Corteil/sdhexpansion/sdhexpansion_v1/bom.csv

Comment | Designator | Footprint | LCSC
2.2uF | C2,C3 | Capacitor_SMD:C_0603_1608Metric | C23630
2.2kΩ | R2,R3,R4 | Resistor_SMD:R_0603_1608Metric | C4190
Micro_SD_Card | J3 | extras:MICRO-SD_XKTF-001C | C1121870
10kΩ | R5,R6,R7,R8,R9 | Resistor_SMD:R_0603_1608Metric | C25804
ZD24C64A-SSGMT | U1 | Package_SO:SOIC-8_3.9x4.9mm_P1.27mm | C2896793
TPS2041B | U2 | Package_TO_SOT_SMD:SOT-23-5 | C24593
