Corteil/sdhexpansion/sdhexpansion.kicad_pcb

## KiCad design sdhexpansion.kicad_pcb (2026-05-31)

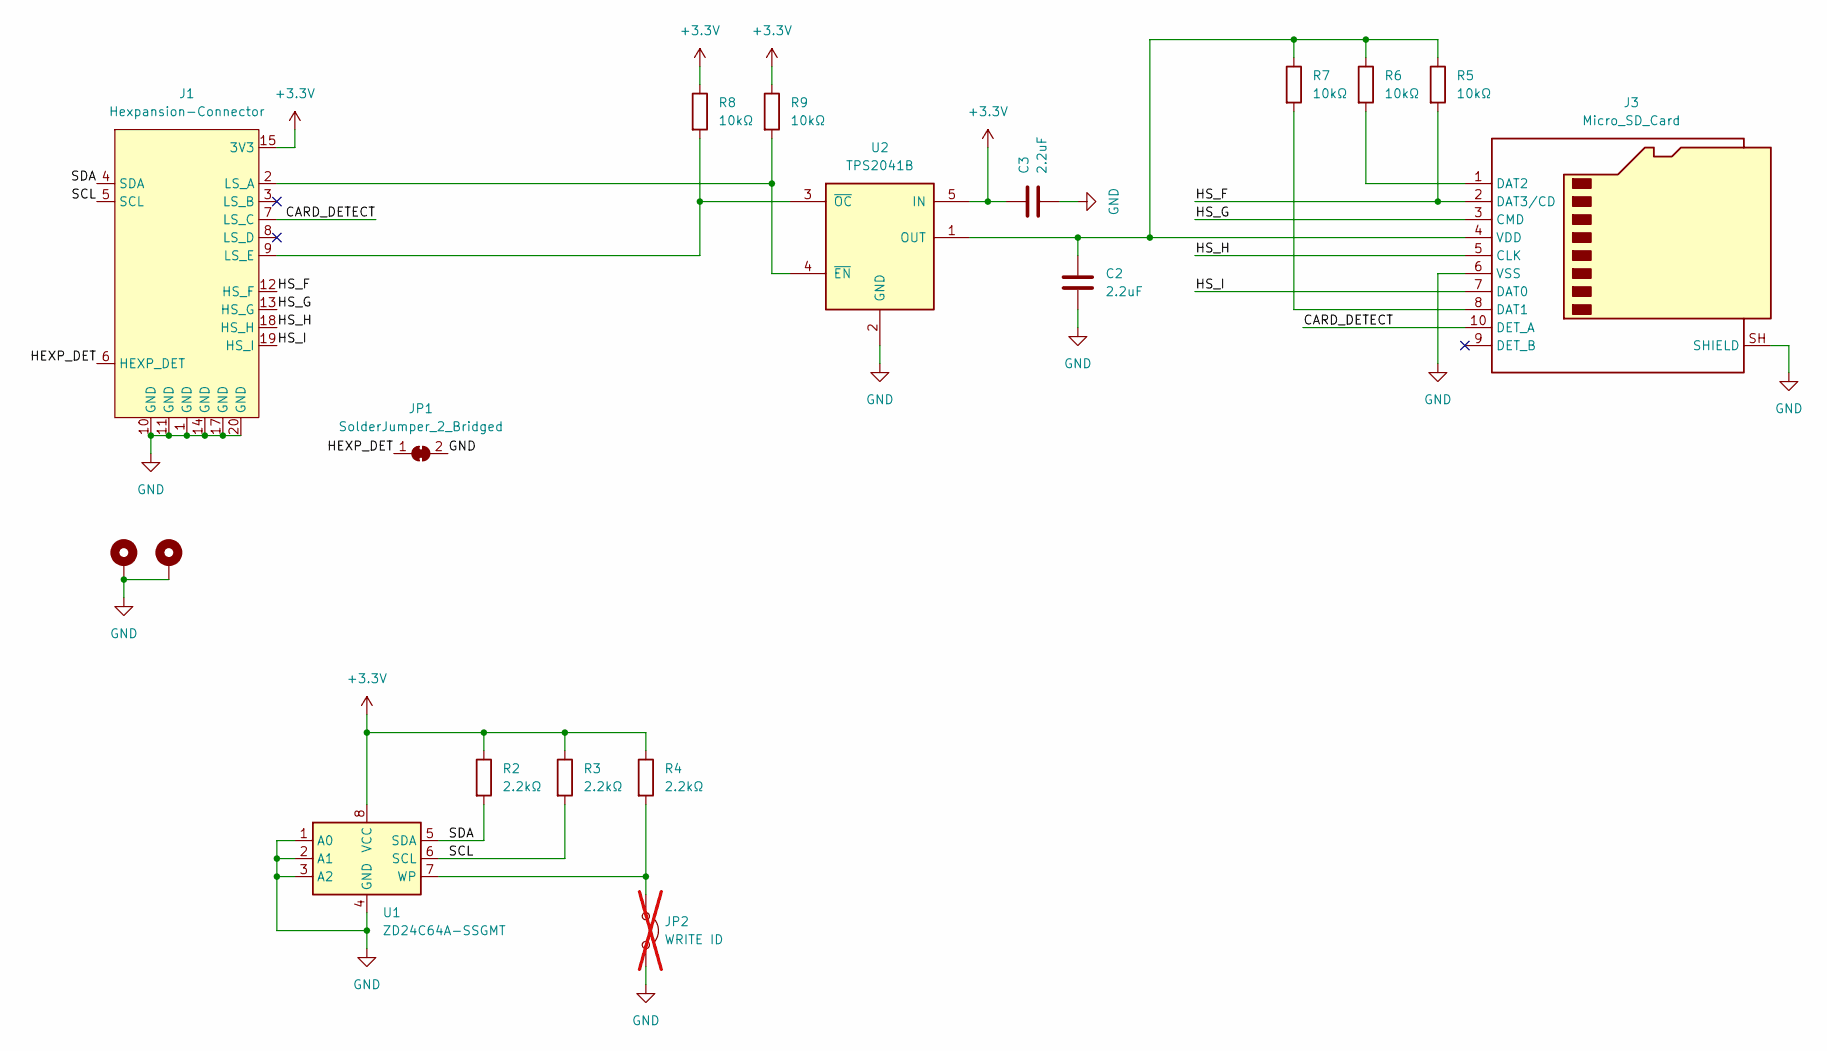
[picture p2: schematic sdhexpansion.kicad_sch]

Parts:
C2, C3: 2.2uF; C_0603_1608Metric; LCSC C23630
H1, H2: MountingHole_Pad; MountingHole_2.2mm_M2_Pad_Via
J1: Hexpansion-Connector; hexpansion-edge-connector
J3: Micro_SD_Card; MICRO-SD_XKTF-001C; LCSC C1121870
JP1: SolderJumper_2_Bridged; SolderJumper-2_P1.3mm_Bridged_RoundedPad1.0x1.5mm
JP2: WRITE ID; PinHeader_1x02_P2.54mm_Vertical; not fitted
R2, R3, R4: 2.2kΩ; R_0603_1608Metric; LCSC C4190
R5, R6, R7, R8, R9: 10kΩ; R_0603_1608Metric; LCSC C25804
U1: ZD24C64A-SSGMT; SOIC-8_3.9x4.9mm_P1.27mm; LCSC C2896793
U2: TPS2041B; SOT-23-5; LCSC C24593

Connections:
+3.3V: C3.2, J1.15 (3V3), J1.16 (3V3), R2.1, R3.1, R4.1, R8.1, R9.1, U1.8 (VCC), U2.5 (IN)
/CARD_DETECT: J1.7 (LS_C), J3.10 (DET_A)
/HEXP_DET: J1.6 (HEXP_DET), JP1.1 (A)
/HS_F: J1.12 (HS_F), J3.2 (DAT3/CD), R5.2
/HS_G: J1.13 (HS_G), J3.3 (CMD)
/HS_H: J1.18 (HS_H), J3.5 (CLK)
/HS_I: J1.19 (HS_I), J3.7 (DAT0)
/SCL: J1.5 (SCL), R3.2, U1.6 (SCL)
/SDA: J1.4 (SDA), R2.2, U1.5 (SDA)
GND: C2.1, C3.1, H1.1 (1_1), H2.1 (1_1), J1.1 (GND), J1.10 (GND), J1.11 (GND), J1.14 (GND), J1.17 (GND), J1.20 (GND), J3.6 (VSS), J3.SH (SHIELD), JP1.2 (B), JP2.2 (B), U1.1 (A0), U1.2 (A1), U1.3 (A2), U1.4 (GND), U2.2 (GND)
unnamed: J1.2 (LS_A), R9.2, U2.4 (~EN)
unnamed: J1.9 (LS_E), R8.2, U2.3 (~OC)
unnamed: J3.8 (DAT1), R7.2
unnamed: J3.1 (DAT2), R6.2
unnamed: C2.2, J3.4 (VDD), R5.1, R6.1, R7.1, U2.1 (OUT)
unnamed: JP2.1 (A), R4.2, U1.7 (WP)

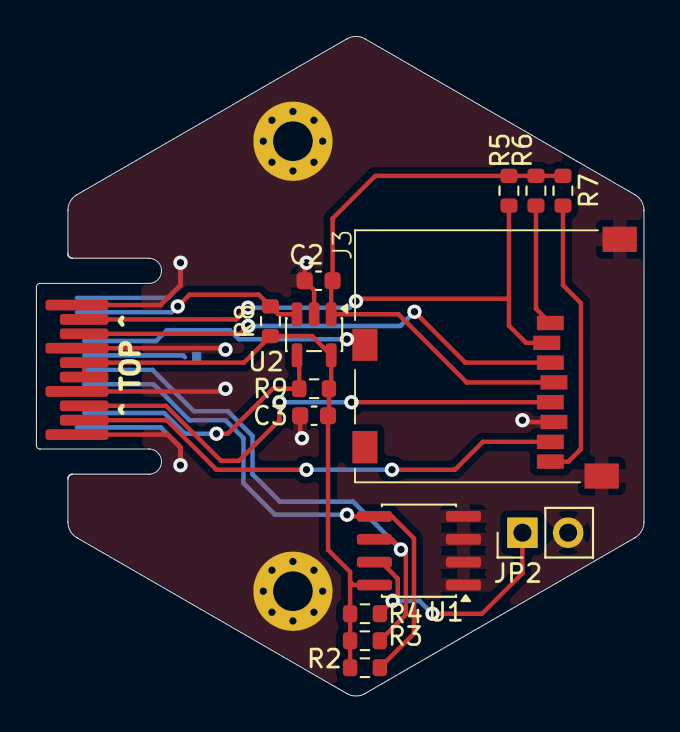
[picture p3: board sdhexpansion.kicad_pcb from above]

Board: 2 copper layers, 33.7 x 36.6 mm, 18 parts (1 on the bottom side), 16 nets.
