Corteil/sdhexpansion/sdhexpansion-panel.kicad_pcb

## KiCad design sdhexpansion-panel.kicad_pcb (2026-05-31)

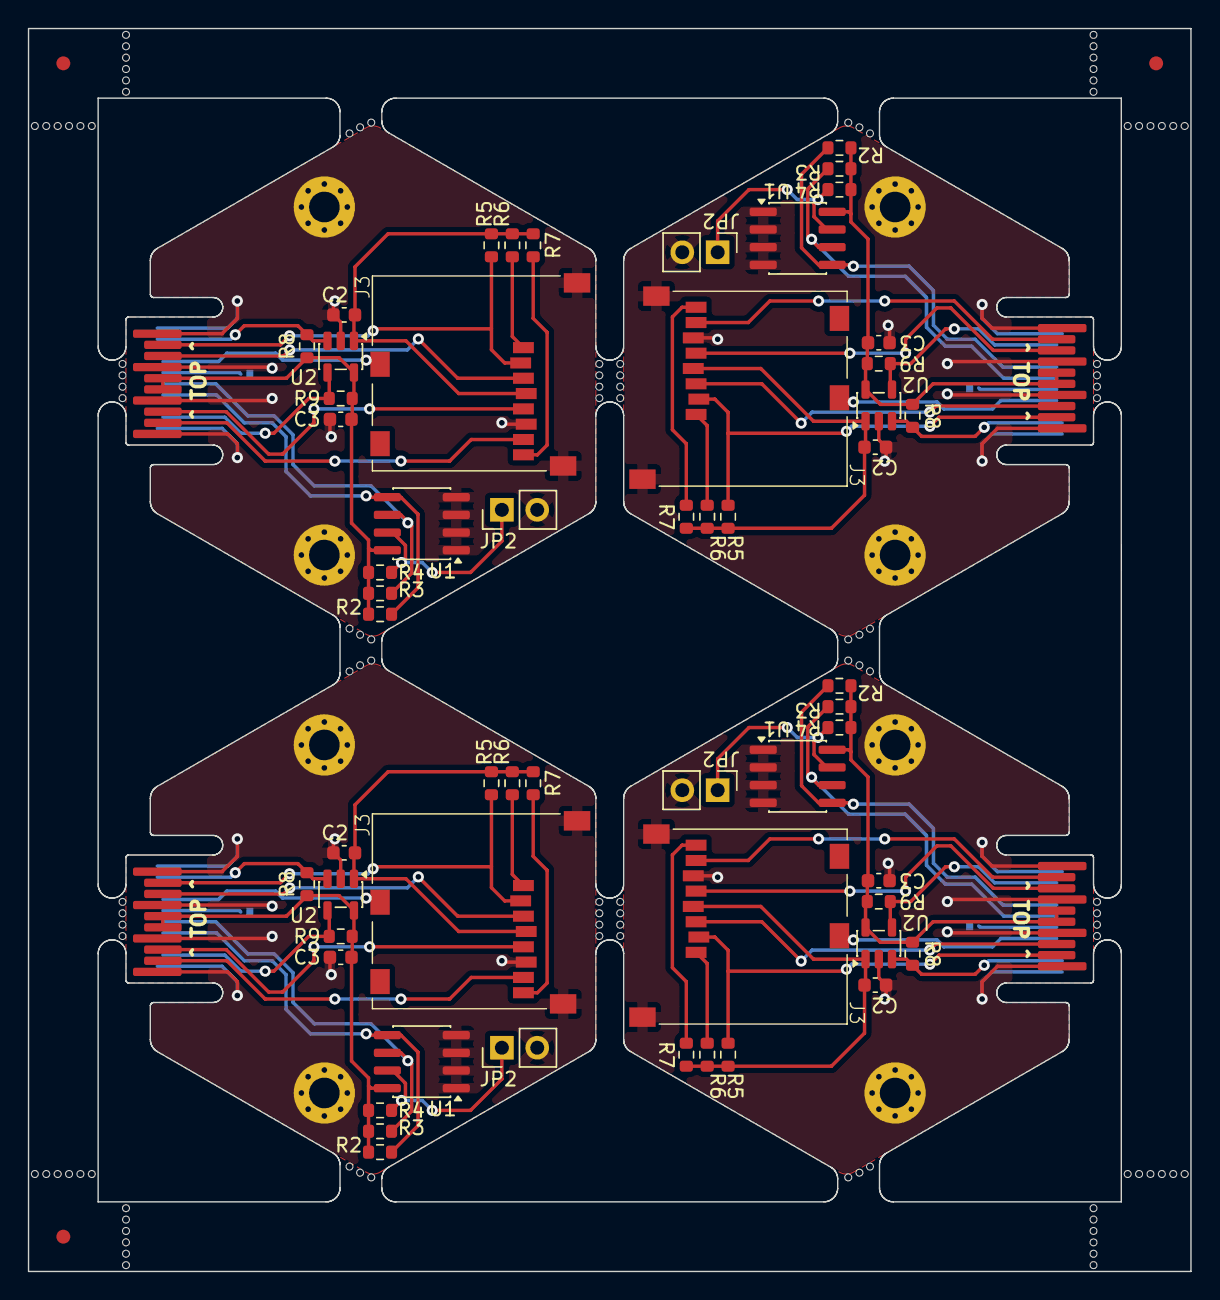
[picture p4: board sdhexpansion-panel.kicad_pcb from above]

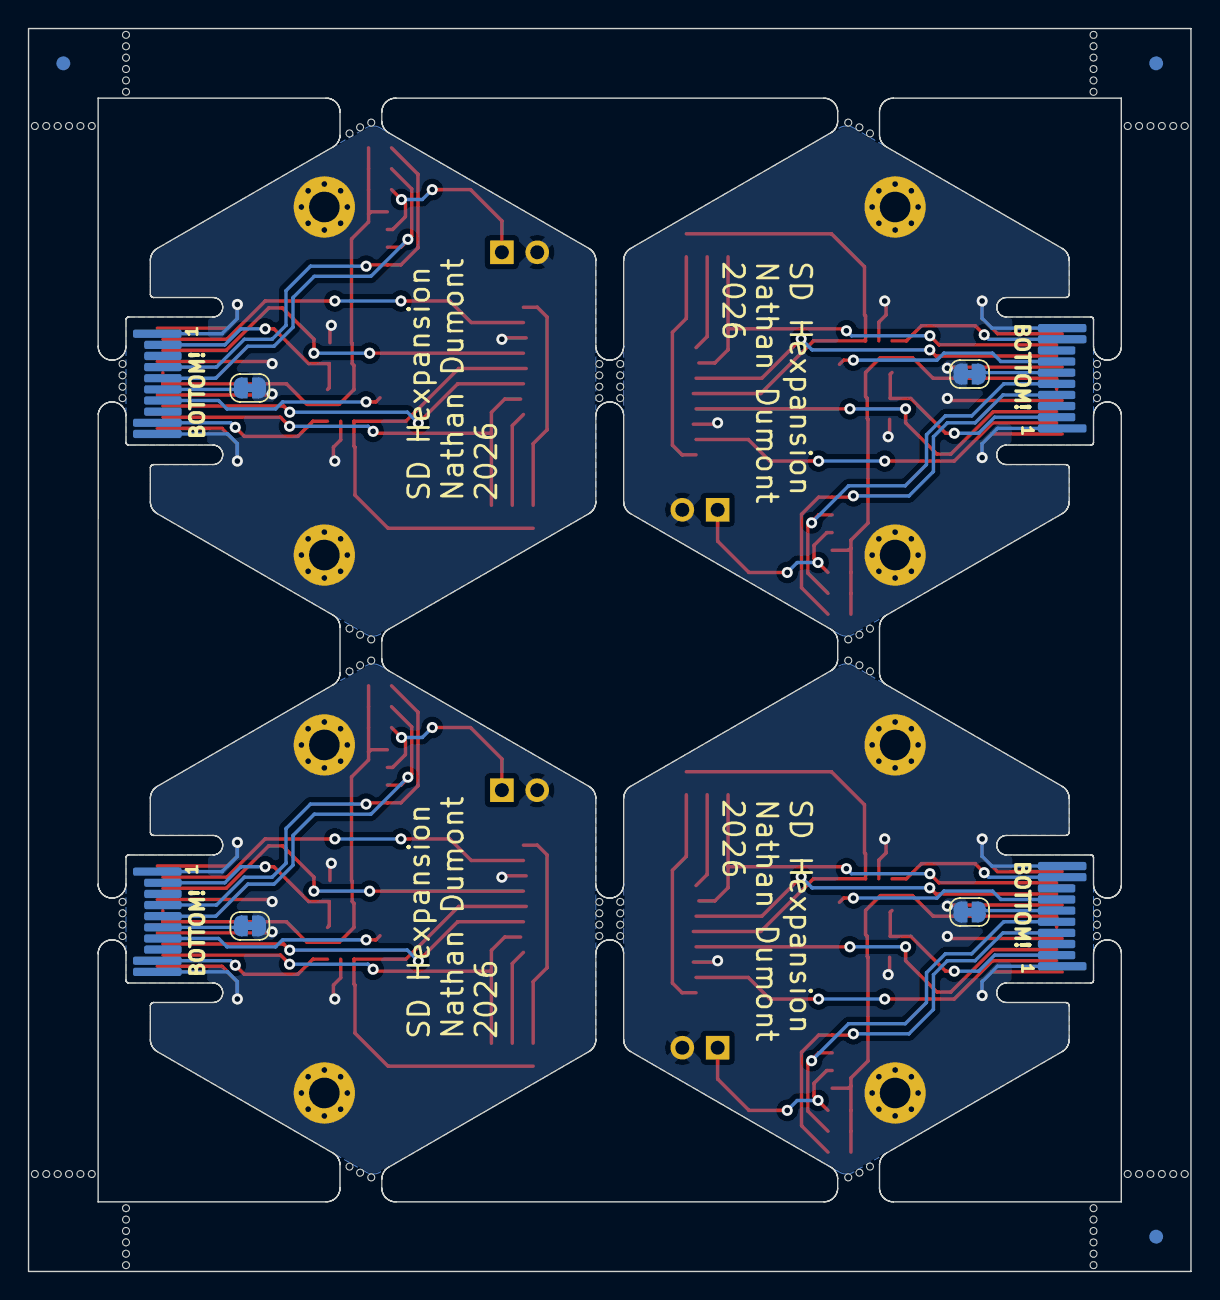
[picture p5: board sdhexpansion-panel.kicad_pcb from below]

Board: 2 copper layers, 83.5 x 89.3 mm, 182 parts (7 on the bottom side), 64 nets.

Parts:
C2, C2#2, C2#3, C2#4, C3, C3#2, C3#3, C3#4: 2.2uF; C_0603_1608Metric
H1, H1#2, H1#3, H1#4, H2, H2#2, H2#3, H2#4: MountingHole_Pad; MountingHole_2.2mm_M2_Pad_Via
J1, J1#2, J1#3, J1#4: Hexpansion-Connector; hexpansion-edge-connector
J3, J3#2, J3#3, J3#4: Micro_SD_Card; MICRO-SD_XKTF-001C
JP1, JP1#2, JP1#3, JP1#4: SolderJumper_2_Bridged; SolderJumper-2_P1.3mm_Bridged_RoundedPad1.0x1.5mm
JP2, JP2#2, JP2#3, JP2#4: WRITE ID; PinHeader_1x02_P2.54mm_Vertical
KiKit_FID_B_1, KiKit_FID_B_2, KiKit_FID_B_3: Fiducial
KiKit_FID_T_1, KiKit_FID_T_2, KiKit_FID_T_3: Fiducial
KiKit_MB_1_5, KiKit_MB_1_6, KiKit_MB_1_7, KiKit_MB_1_8, KiKit_MB_2_5, KiKit_MB_2_6, KiKit_MB_2_7, KiKit_MB_2_8, KiKit_MB_3_5, KiKit_MB_3_6, KiKit_MB_3_7, KiKit_MB_4_5, KiKit_MB_4_6, KiKit_MB_4_7, KiKit_MB_5_5, KiKit_MB_5_6, KiKit_MB_5_7, KiKit_MB_5_8, KiKit_MB_6_5, KiKit_MB_6_6, KiKit_MB_6_7, KiKit_MB_6_8, KiKit_MB_7_5, KiKit_MB_7_6, KiKit_MB_7_7, KiKit_MB_8_5, KiKit_MB_8_6, KiKit_MB_8_7, KiKit_MB_9_5, KiKit_MB_9_6, KiKit_MB_9_7, KiKit_MB_9_8, KiKit_MB_10_5, KiKit_MB_10_6, KiKit_MB_10_7, KiKit_MB_10_8, KiKit_MB_11_5, KiKit_MB_11_6, KiKit_MB_11_7, KiKit_MB_12_5, KiKit_MB_12_6, KiKit_MB_12_7, KiKit_MB_13_5, KiKit_MB_13_6, KiKit_MB_13_7, KiKit_MB_13_8, KiKit_MB_14_5, KiKit_MB_14_6, KiKit_MB_14_7, KiKit_MB_14_8, KiKit_MB_15_5, KiKit_MB_15_6, KiKit_MB_15_7, KiKit_MB_16_5, KiKit_MB_16_6, KiKit_MB_16_7, KiKit_MB_17_4, KiKit_MB_17_5, KiKit_MB_17_6, KiKit_MB_17_7, KiKit_MB_17_8, KiKit_MB_17_9, KiKit_MB_18_4, KiKit_MB_18_5, KiKit_MB_18_6, KiKit_MB_18_7, KiKit_MB_18_8, KiKit_MB_18_9, KiKit_MB_19_4, KiKit_MB_19_5, KiKit_MB_19_6, KiKit_MB_19_7, KiKit_MB_19_8, KiKit_MB_19_9, KiKit_MB_20_4, KiKit_MB_20_5, KiKit_MB_20_6, KiKit_MB_20_7, KiKit_MB_20_8, KiKit_MB_20_9, KiKit_MB_21_4, KiKit_MB_21_5, KiKit_MB_21_6, KiKit_MB_21_7, KiKit_MB_21_8, KiKit_MB_21_9, KiKit_MB_22_4, KiKit_MB_22_5, KiKit_MB_22_6, KiKit_MB_22_7, KiKit_MB_22_8, KiKit_MB_22_9, KiKit_MB_23_4, KiKit_MB_23_5, KiKit_MB_23_6, KiKit_MB_23_7, KiKit_MB_23_8, KiKit_MB_23_9, KiKit_MB_24_4, KiKit_MB_24_5, KiKit_MB_24_6, KiKit_MB_24_7, KiKit_MB_24_8, KiKit_MB_24_9: NPTH
R2, R2#2, R2#3, R2#4, R3, R3#2, R3#3, R3#4, R4, R4#2, R4#3, R4#4: 2.2kΩ; R_0603_1608Metric
R5, R5#2, R5#3, R5#4, R6, R6#2, R6#3, R6#4, R7, R7#2, R7#3, R7#4, R8, R8#2, R8#3, R8#4, R9, R9#2, R9#3, R9#4: 10kΩ; R_0603_1608Metric
U1, U1#2, U1#3, U1#4: ZD24C64A-SSGMT; SOIC-8_3.9x4.9mm_P1.27mm
U2, U2#2, U2#3, U2#4: TPS2041B; SOT-23-5

Connections:
Board_0-+3.3V: C3.2, J1.15 (3V3), J1.16 (3V3), R2.1, R3#3.1, R4#2.1, R8#4.1, R9#3.1, U1#4.8 (VCC), U2#3.5 (IN)
Board_0-/CARD_DETECT: J1.7 (LS_C), J3#4.10 (DET_A)
Board_0-/HEXP_DET: J1.6 (HEXP_DET), JP1#4.1 (A)
Board_0-/HS_F: J1.12 (HS_F), J3#4.2 (DAT3/CD), R5.2
Board_0-/HS_G: J1.13 (HS_G), J3#4.3 (CMD)
Board_0-/HS_H: J1.18 (HS_H), J3#4.5 (CLK)
Board_0-/HS_I: J1.19 (HS_I), J3#4.7 (DAT0)
Board_0-/SCL: J1.5 (SCL), R3#3.2, U1#4.6 (SCL)
Board_0-/SDA: J1.4 (SDA), R2.2, U1#4.5 (SDA)
Board_0-GND: C2#2.1, C3.1, H1#2.1 (1_1), H2.1 (1_1), J1.1 (GND), J1.10 (GND), J1.11 (GND), J1.14 (GND), J1.17 (GND), J1.20 (GND), J3#4.6 (VSS), J3#4.SH (SHIELD), JP1#4.2 (B), JP2.2 (B), U1#4.1 (A0), U1#4.2 (A1), U1#4.3 (A2), U1#4.4 (GND), U2#3.2 (GND)
Board_0-Net-(J1-LS_A): J1.2 (LS_A), R9#3.2, U2#3.4 (~EN)
Board_0-Net-(J1-LS_E): J1.9 (LS_E), R8#4.2, U2#3.3 (~OC)
Board_0-Net-(J3-DAT1): J3#4.8 (DAT1), R7#4.2
Board_0-Net-(J3-DAT2): J3#4.1 (DAT2), R6.2
Board_0-Net-(J3-VDD): C2#2.2, J3#4.4 (VDD), R5.1, R6.1, R7#4.1, U2#3.1 (OUT)
Board_0-Net-(JP2-A): JP2.1 (A), R4#2.2, U1#4.7 (WP)
Board_1-+3.3V: C3#3.2, J1#2.15 (3V3), J1#2.16 (3V3), R2#4.1, R3.1, R4#3.1, R8#2.1, R9.1, U1.8 (VCC), U2#4.5 (IN)
Board_1-/CARD_DETECT: J1#2.7 (LS_C), J3#2.10 (DET_A)
Board_1-/HEXP_DET: J1#2.6 (HEXP_DET), JP1.1 (A)
Board_1-/HS_F: J1#2.12 (HS_F), J3#2.2 (DAT3/CD), R5#3.2
Board_1-/HS_G: J1#2.13 (HS_G), J3#2.3 (CMD)
Board_1-/HS_H: J1#2.18 (HS_H), J3#2.5 (CLK)
Board_1-/HS_I: J1#2.19 (HS_I), J3#2.7 (DAT0)
Board_1-/SCL: J1#2.5 (SCL), R3.2, U1.6 (SCL)
Board_1-/SDA: J1#2.4 (SDA), R2#4.2, U1.5 (SDA)
Board_1-GND: C2.1, C3#3.1, H1.1 (1_1), H2#2.1 (1_1), J1#2.1 (GND), J1#2.10 (GND), J1#2.11 (GND), J1#2.14 (GND), J1#2.17 (GND), J1#2.20 (GND), J3#2.6 (VSS), J3#2.SH (SHIELD), JP1.2 (B), JP2#2.2 (B), U1.1 (A0), U1.2 (A1), U1.3 (A2), U1.4 (GND), U2#4.2 (GND)
Board_1-Net-(J1-LS_A): J1#2.2 (LS_A), R9.2, U2#4.4 (~EN)
Board_1-Net-(J1-LS_E): J1#2.9 (LS_E), R8#2.2, U2#4.3 (~OC)
Board_1-Net-(J3-DAT1): J3#2.8 (DAT1), R7.2
Board_1-Net-(J3-DAT2): J3#2.1 (DAT2), R6#2.2
Board_1-Net-(J3-VDD): C2.2, J3#2.4 (VDD), R5#3.1, R6#2.1, R7.1, U2#4.1 (OUT)
Board_1-Net-(JP2-A): JP2#2.1 (A), R4#3.2, U1.7 (WP)
Board_2-+3.3V: C3#4.2, J1#4.15 (3V3), J1#4.16 (3V3), R2#3.1, R3#2.1, R4.1, R8.1, R9#2.1, U1#3.8 (VCC), U2.5 (IN)
Board_2-/CARD_DETECT: J1#4.7 (LS_C), J3#3.10 (DET_A)
Board_2-/HEXP_DET: J1#4.6 (HEXP_DET), JP1#3.1 (A)
Board_2-/HS_F: J1#4.12 (HS_F), J3#3.2 (DAT3/CD), R5#2.2
Board_2-/HS_G: J1#4.13 (HS_G), J3#3.3 (CMD)
Board_2-/HS_H: J1#4.18 (HS_H), J3#3.5 (CLK)
Board_2-/HS_I: J1#4.19 (HS_I), J3#3.7 (DAT0)
Board_2-/SCL: J1#4.5 (SCL), R3#2.2, U1#3.6 (SCL)
Board_2-/SDA: J1#4.4 (SDA), R2#3.2, U1#3.5 (SDA)
Board_2-GND: C2#4.1, C3#4.1, H1#3.1 (1_1), H2#3.1 (1_1), J1#4.1 (GND), J1#4.10 (GND), J1#4.11 (GND), J1#4.14 (GND), J1#4.17 (GND), J1#4.20 (GND), J3#3.6 (VSS), J3#3.SH (SHIELD), JP1#3.2 (B), JP2#4.2 (B), U1#3.1 (A0), U1#3.2 (A1), U1#3.3 (A2), U1#3.4 (GND), U2.2 (GND)
Board_2-Net-(J1-LS_A): J1#4.2 (LS_A), R9#2.2, U2.4 (~EN)
Board_2-Net-(J1-LS_E): J1#4.9 (LS_E), R8.2, U2.3 (~OC)
Board_2-Net-(J3-DAT1): J3#3.8 (DAT1), R7#2.2
Board_2-Net-(J3-DAT2): J3#3.1 (DAT2), R6#4.2
Board_2-Net-(J3-VDD): C2#4.2, J3#3.4 (VDD), R5#2.1, R6#4.1, R7#2.1, U2.1 (OUT)
Board_2-Net-(JP2-A): JP2#4.1 (A), R4.2, U1#3.7 (WP)
Board_3-+3.3V: C3#2.2, J1#3.15 (3V3), J1#3.16 (3V3), R2#2.1, R3#4.1, R4#4.1, R8#3.1, R9#4.1, U1#2.8 (VCC), U2#2.5 (IN)
Board_3-/CARD_DETECT: J1#3.7 (LS_C), J3.10 (DET_A)
Board_3-/HEXP_DET: J1#3.6 (HEXP_DET), JP1#2.1 (A)
Board_3-/HS_F: J1#3.12 (HS_F), J3.2 (DAT3/CD), R5#4.2
Board_3-/HS_G: J1#3.13 (HS_G), J3.3 (CMD)
Board_3-/HS_H: J1#3.18 (HS_H), J3.5 (CLK)
Board_3-/HS_I: J1#3.19 (HS_I), J3.7 (DAT0)
Board_3-/SCL: J1#3.5 (SCL), R3#4.2, U1#2.6 (SCL)
Board_3-/SDA: J1#3.4 (SDA), R2#2.2, U1#2.5 (SDA)
Board_3-GND: C2#3.1, C3#2.1, H1#4.1 (1_1), H2#4.1 (1_1), J1#3.1 (GND), J1#3.10 (GND), J1#3.11 (GND), J1#3.14 (GND), J1#3.17 (GND), J1#3.20 (GND), J3.6 (VSS), J3.SH (SHIELD), JP1#2.2 (B), JP2#3.2 (B), U1#2.1 (A0), U1#2.2 (A1), U1#2.3 (A2), U1#2.4 (GND), U2#2.2 (GND)
Board_3-Net-(J1-LS_A): J1#3.2 (LS_A), R9#4.2, U2#2.4 (~EN)
Board_3-Net-(J1-LS_E): J1#3.9 (LS_E), R8#3.2, U2#2.3 (~OC)
Board_3-Net-(J3-DAT1): J3.8 (DAT1), R7#3.2
Board_3-Net-(J3-DAT2): J3.1 (DAT2), R6#3.2
Board_3-Net-(J3-VDD): C2#3.2, J3.4 (VDD), R5#4.1, R6#3.1, R7#3.1, U2#2.1 (OUT)
Board_3-Net-(JP2-A): JP2#3.1 (A), R4#4.2, U1#2.7 (WP)
