Corteil/sdhexpansion/(commit log)

2026-05-31 Initial commit, board files as ordered
    [bom.csv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]
2026-10-24 Add auto mount and quiet start options
    Both are toggles in the app menu, stored in the badge settings.
    Quiet start skips the foreground push on insertion; the app lists
    itself in the launcher so it can still be opened. A failed auto mount
    brings the app forward to show the error. Rebuild app.mpy.
    [app.py]
2026-10-24 Document auto mount and quiet start options
